NoahDobie/pajero-gauges/hardware/pcb/jlcpcb/Bottom.png

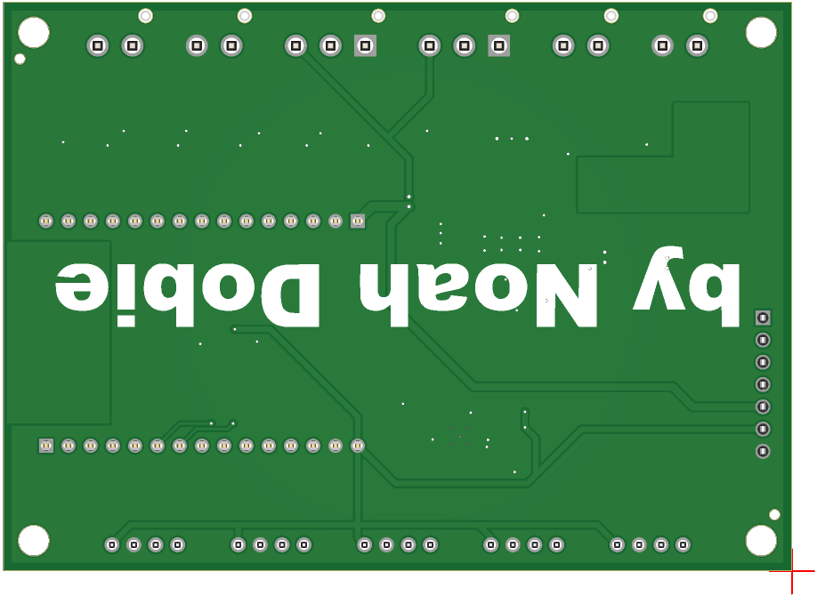
hardware/pcb/jlcpcb/Bottom.png
