NoahDobie/pajero-gauges/hardware/pcb/jlcpcb/Top.png

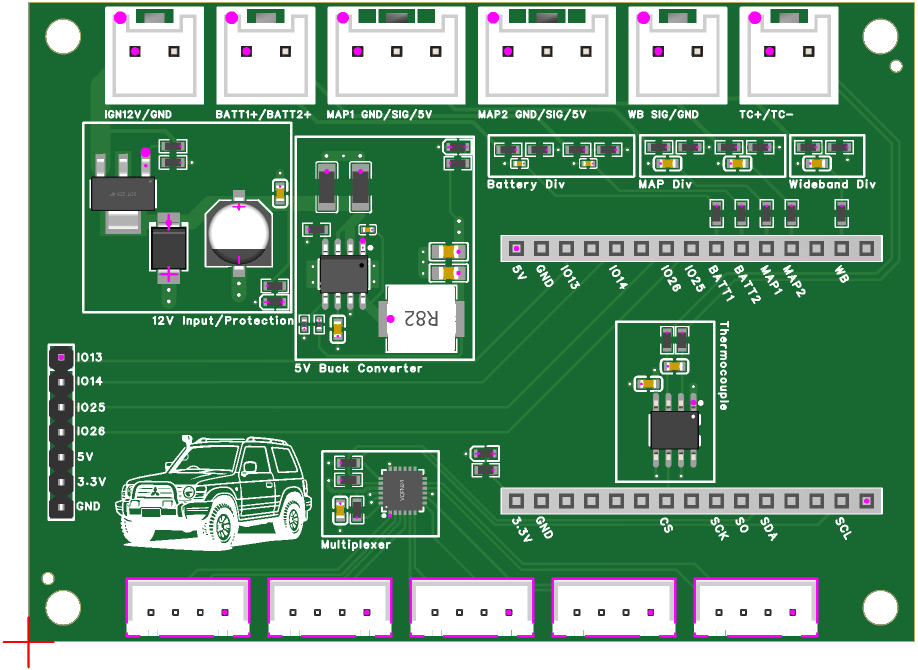
hardware/pcb/jlcpcb/Top.png
