NoahDobie/pajero-gauges/hardware/pcb/production-files/BOM.xlsx

No. | Quantity | Comment | Designator | Footprint | Value | Manufacturer Part | Manufacturer | Supplier Part | Supplier
1 | 1 | 100uF | C1 | CAP-SMD_BD6.3-L6.6-W6.6-LS7.3-FD-H7.7 | 100uF | RVT50V100M6X8 | JIERR(捷而瑞) | C47023117 | LCSC
2 | 3 | 100nF | C2,C15,C50 | C0603 | 100nF | CC0603KRX7R9BB104 | YAGEO(国巨) | C14663 | LCSC
3 | 3 | 100nF | C5,C67,C69 | C0402 | 100nF | CL05B104KB54PNC | SAMSUNG(三星) | C307331 | LCSC
4 | 2 | 22uF | C6,C7 | C0805 | 22uF | CL21A226MAQNNNE | SAMSUNG(三星) | C45783 | LCSC
5 | 2 | 10nF | C8,C14 | C0603 | 10nF | 0603B103K500NT | FH(风华) | C57112 | LCSC
6 | 3 | 47nF | C9,C12,C70 | C0603 | 47nF | CL10B473KB8NNNC | SAMSUNG(三星) | C1622 | LCSC
7 | 2 | 10uF | C51,C52 | C1206 | 10uF | CL31A106KBHNNNE | SAMSUNG(三星) | C13585 | LCSC
8 | 1 | SMBJ18A-Q | D1 | SMB_L4.3-W3.6-LS5.4-RD |  | SMBJ18A-Q | BOURNS | C1979859 | LCSC
9 | 4 | B2P-VH-FB-B(LF)(SN) | H1,H3,H6,H7 | CONN-TH_2P-P3.96_B2P-VH-FB-B-LF-SN |  | B2P-VH-FB-B(LF)(SN) | JST | C158006 | LCSC
10 | 2 | B3P-VH-FB-B(LF)(SN) | H4,H5 | CONN-TH_B3P-VH-FB-B-LF-SN |  | B3P-VH-FB-B(LF)(SN) | JST | C158000 | LCSC
11 | 5 | B4B-XH-A(LF)(SN) | H8,H9,H10,H11,H12 | CONN-TH_B4B-XH-A-LF-SN |  | B4B-XH-A(LF)(SN) | JST | C144395 | LCSC
12 | 1 | HX PZ2.54-1x7P ZZ | H13 | HDR-TH_7P-P2.54-V-M |  | HX PZ2.54-1x7P ZZ | hanxia(韩下) | C32713273 | LCSC
13 | 1 | 5.6uH | L1 | IND-SMD_L7.0-W6.6_FXL0630 | 5.6uH | FXL0630-5R6-M | cjiang(长江微电) | C475914 | LCSC
14 | 3 | KT-0603R | LED1,LED4,LED5 | LED0603-RD |  | KT-0603R | KENTO | C2286 | LCSC
15 | 1 | NTF2955T1G | Q1 | SOT-223-4_L6.5-W3.5-P2.30-LS7.0-BR |  | NTF2955T1G | onsemi(安森美) | C17265 | LCSC
16 | 5 | 10kΩ | R1,R3,R17,R18,R23 | R0603 | 10kΩ | 0603WAF1002T5E | UNI-ROYAL(厚声) | C25804 | LCSC
17 | 3 | 100kΩ | R2,R21,R22 | R0603 | 100kΩ | 0603WAF1003T5E | UNI-ROYAL(厚声) | C25803 | LCSC
18 | 6 | 1kΩ | R4,R5,R6,R7,R13,RLED3 | R0603 | 1kΩ | 0603WAF1001T5E | UNI-ROYAL(厚声) | C21190 | LCSC
19 | 3 | 20kΩ | R8,R19,R20 | R0603 | 20kΩ | 0603WAF2002T5E | UNI-ROYAL(厚声) | C4184 | LCSC
20 | 2 | 27kΩ | R9,R10 | R0603 | 27kΩ | 0603WAF2702T5E | UNI-ROYAL(厚声) | C22967 | LCSC
21 | 2 | 5.1kΩ | R11,R12 | R0603 | 5.1kΩ | 0603WAF5101T5E | UNI-ROYAL(厚声) | C23186 | LCSC
22 | 1 | 200kΩ | R14 | R0603 | 200kΩ | 0603WAF2003T5E | UNI-ROYAL(厚声) | C25811 | LCSC
23 | 1 | 115kΩ | R15 | R0402 | 115kΩ | RC0402FR-07115KL | YAGEO(国巨) | C273341 | LCSC
24 | 1 | 22.1kΩ | R16 | R0402 | 22.1kΩ | RMC040222.1K1%N | Tyohm(幸亚电阻) | C325588 | LCSC
25 | 3 | 4.7kΩ | R24,R25,RLED1 | R0603 | 4.7kΩ | 0603WAF4701T5E | UNI-ROYAL(厚声) | C23162 | LCSC
26 | 1 | 1.5kΩ | RLED2 | R0603 | 1.5kΩ | 0603WAF2701T5E | UNI-ROYAL(厚声) |  | LCSC
27 | 1 | MAX31855TASA+T | U1 | SOIC-8_L4.9-W3.9-P1.27-LS6.2-BL |  | MAX31855TASA+T | ADI(亚德诺)/MAXIM(美信) | C476183 | LCSC
28 | 1 | TCA9548ARGERQ1 | U13 | VQFN-24_L4.0-W4.0-P0.50-TL-EP2.8 |  | TCA9548ARGERQ1 | TI(德州仪器) | C2674697 | LCSC
29 | 1 | AP64352QSP-13 | U18 | ESOP-8_L4.9-W3.9-P1.27-LS6.0-BL-EP3.1-1 |  | AP64352QSP-13 | DIODES(美台) | C5248547 | LCSC
30 | 2 | HX PM2.54-1x15P ZC | U19,U20 | HDR-TH_15P-P2.54-V-F-1 |  | HX PM2.54-1x15P ZC | hanxia(韩下) | C41417327 | LCSC
