NoahDobie/pajero-gauges/hardware/schematics/SCH_Schematics.pdf

# TC_CSPGND

15 15 14 14 13 13 12 12 11 11 10 10 9

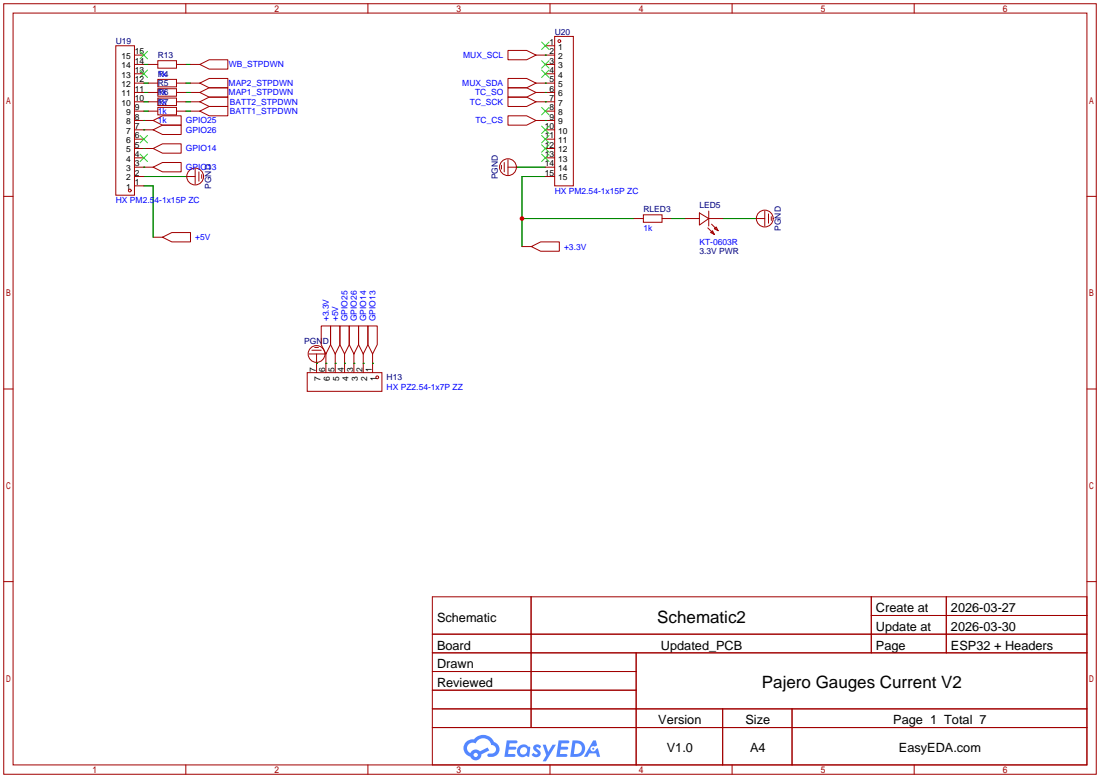
[picture p3: page 1]

Schematic | Schematic2 | Create at | 2026-03-27

Update at | 2026-03-30

Board | Updated_PCB | Page | ESP32 + Headers
Drawn | | Pajero Gauges Current V2
Reviewed

Version | Size | Page 1 Total 7
V1.0 | A4 | EasyEDA.com

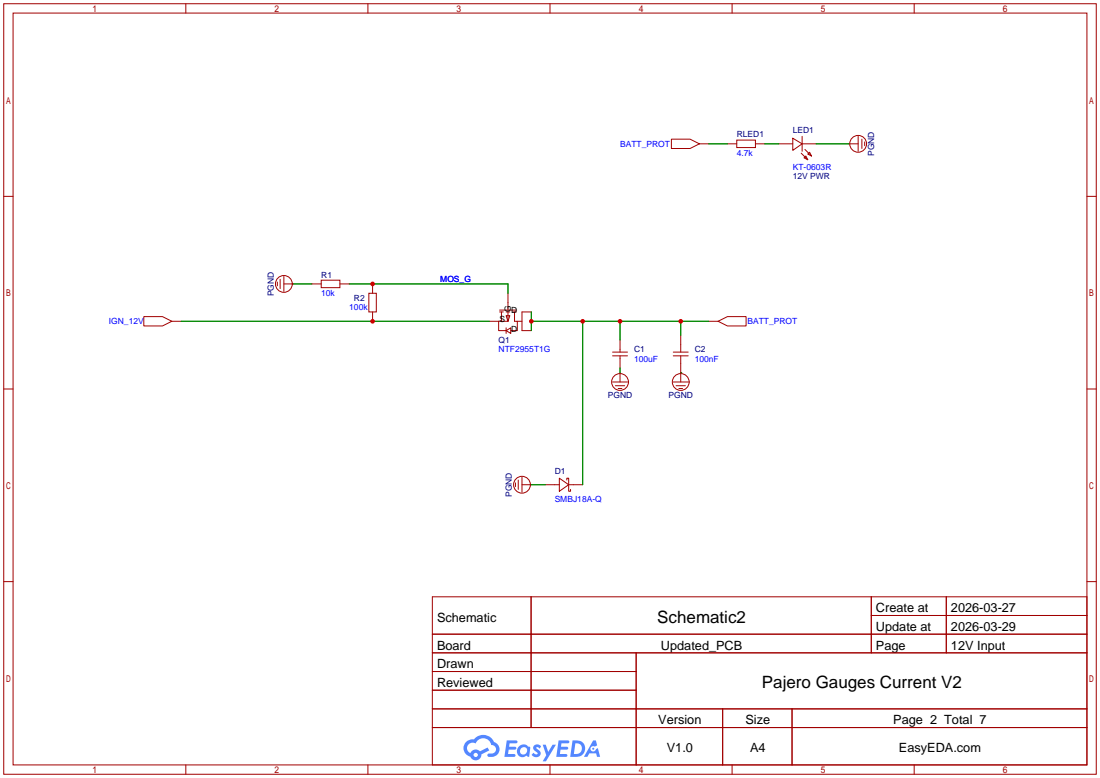
[picture p4: page 2]

Schematic | Schematic2 | Create at | 2026-03-27

Update at | 2026-03-29

Board | Updated_PCB | Page | 12V Input
Drawn | | Pajero Gauges Current V2
Reviewed

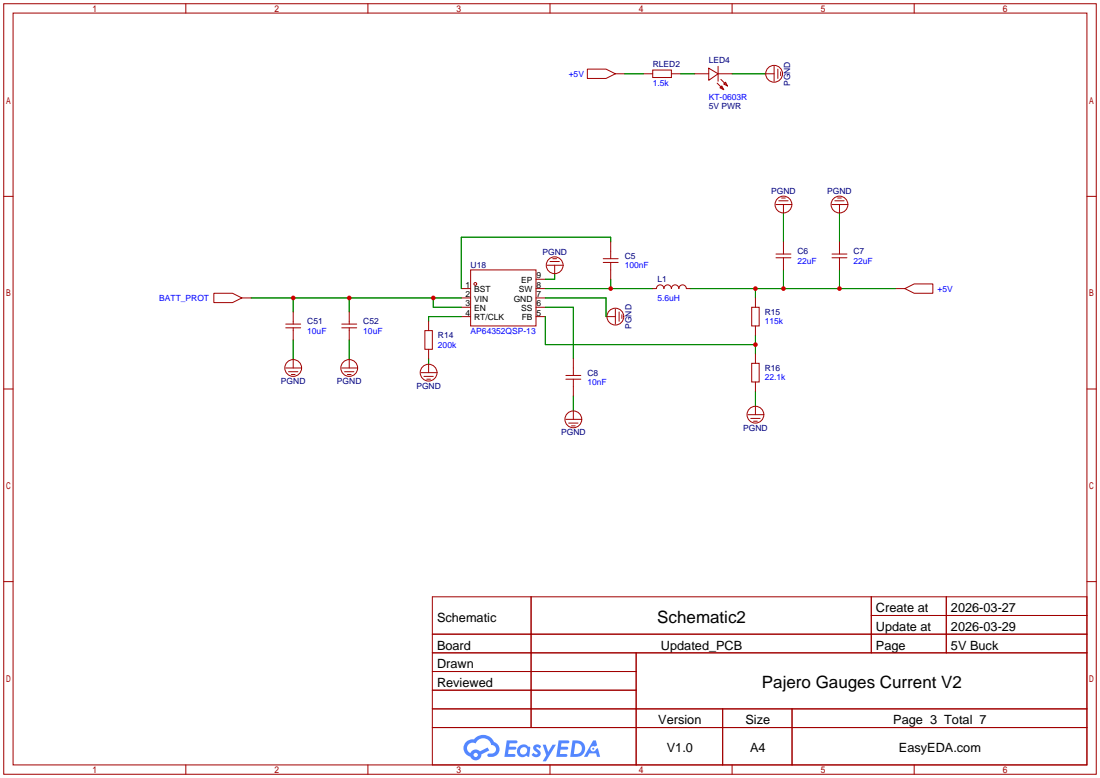
[picture p5: page 3]

Schematic | Schematic2 | Create at | 2026-03-27

Update at | 2026-03-29

Board | Updated_PCB | Page | 5V Buck
Drawn | | Pajero Gauges Current V2
Reviewed

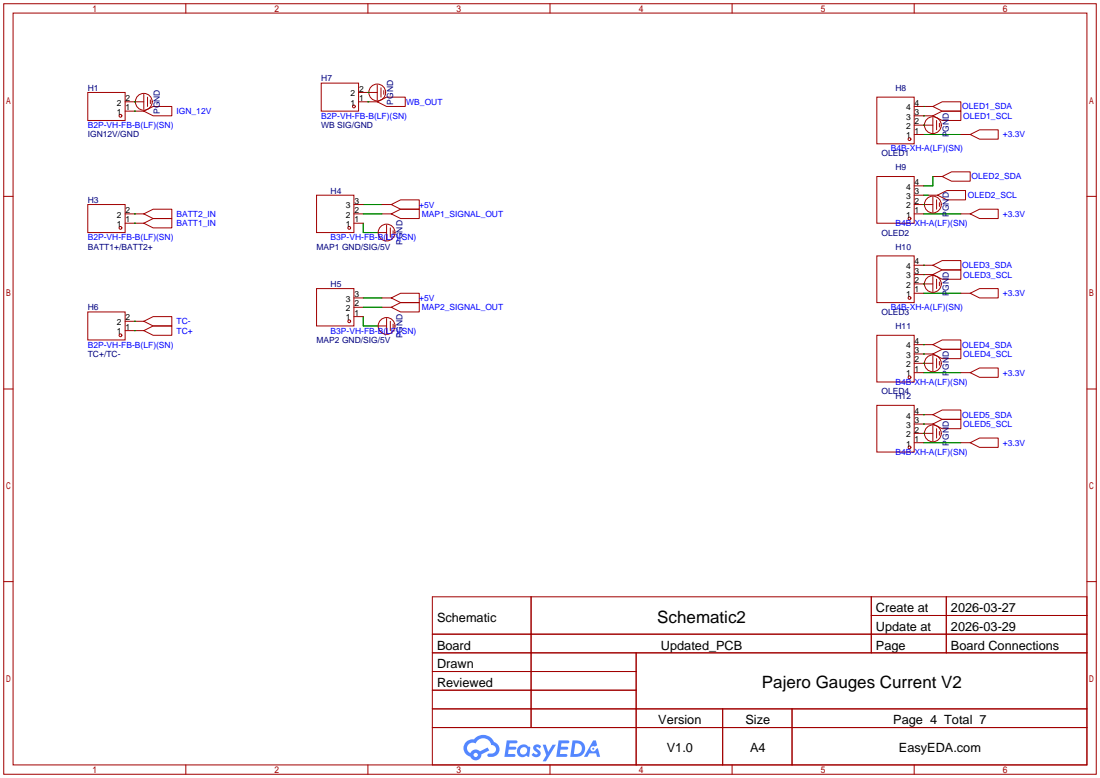
[picture p6: page 4]

Schematic | Schematic2 | Create at | 2026-03-27

Update at | 2026-03-29

Board | Updated_PCB | Page | Board Connections
Drawn | | Pajero Gauges Current V2
Reviewed

# WB_STPDWN PGND PGND

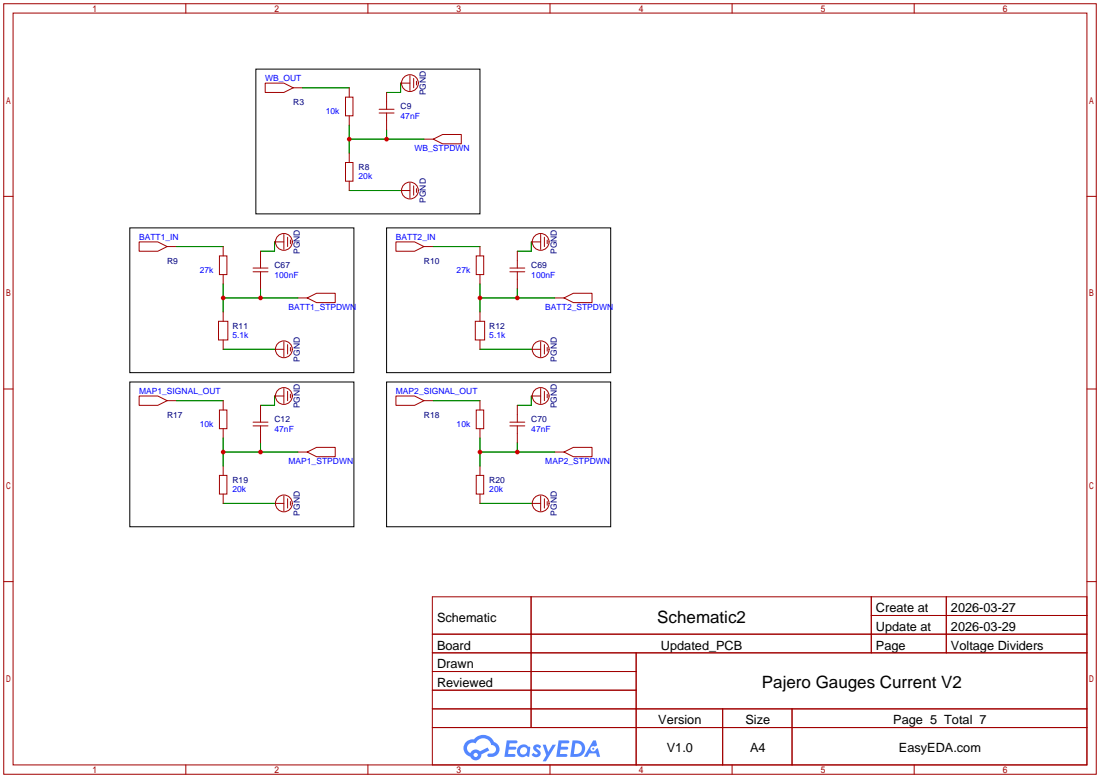
[picture p7: page 5]

Schematic | Schematic2 | Create at | 2026-03-27

Update at | 2026-03-29

Board | Updated_PCB | Page | Voltage Dividers
Drawn | | Pajero Gauges Current V2
Reviewed

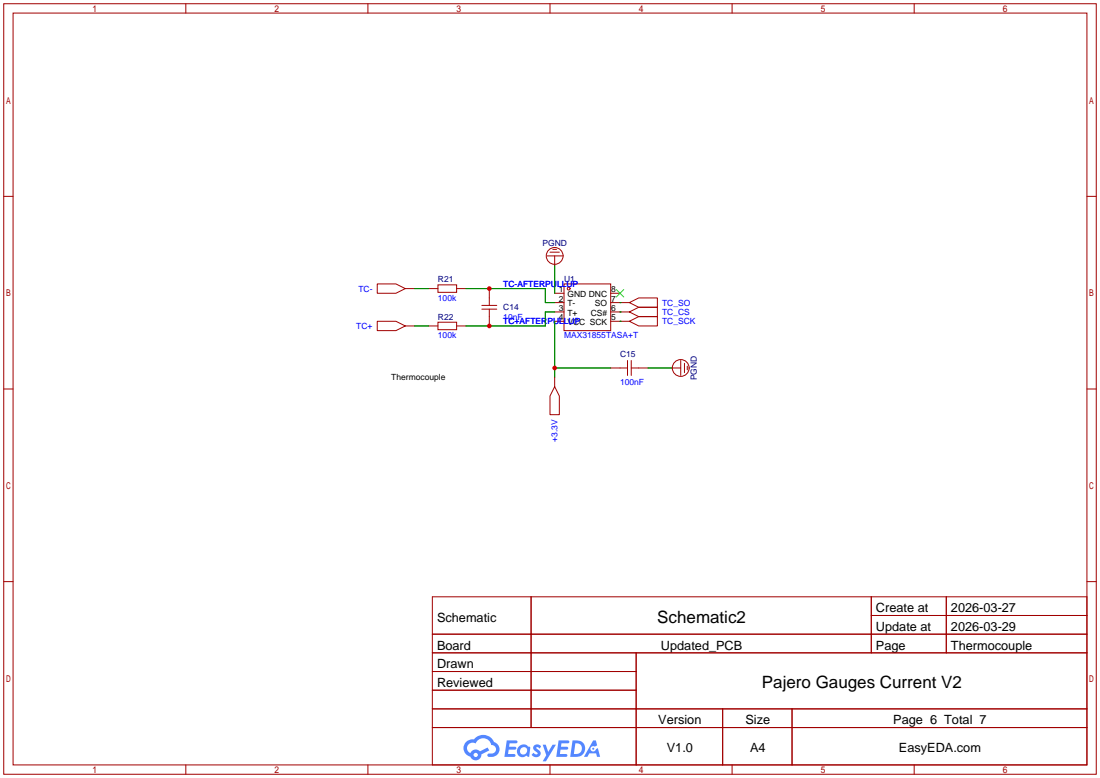
[picture p8: page 6]

Schematic | Schematic2 | Create at | 2026-03-27

Update at | 2026-03-29

Board | Updated_PCB | Page | Thermocouple
Drawn | | Pajero Gauges Current V2
Reviewed

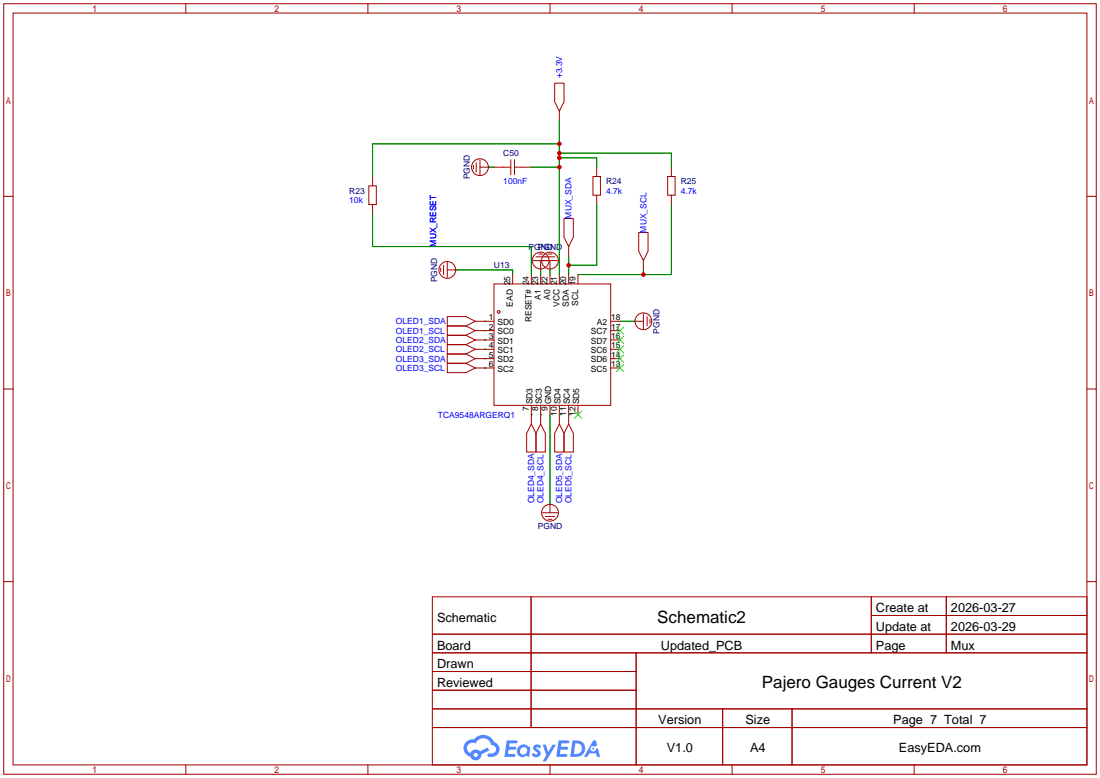
[picture p9: page 7]

Schematic | Schematic2 | Create at | 2026-03-27

Update at | 2026-03-29

Board | Updated_PCB | Page | Mux
Drawn | | Pajero Gauges Current V2
Reviewed
