NoahDobie/pajero-gauges/hardware/pcb/renders/PCB-Images.pdf

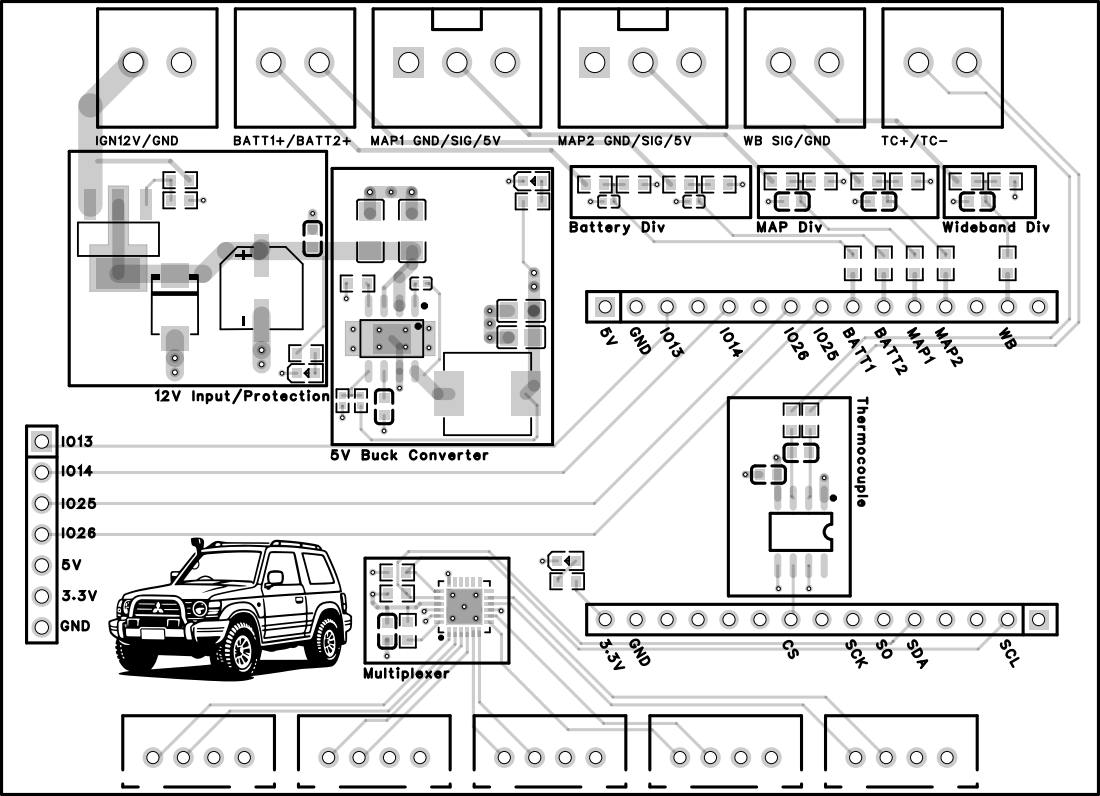
[picture p10: page 1]

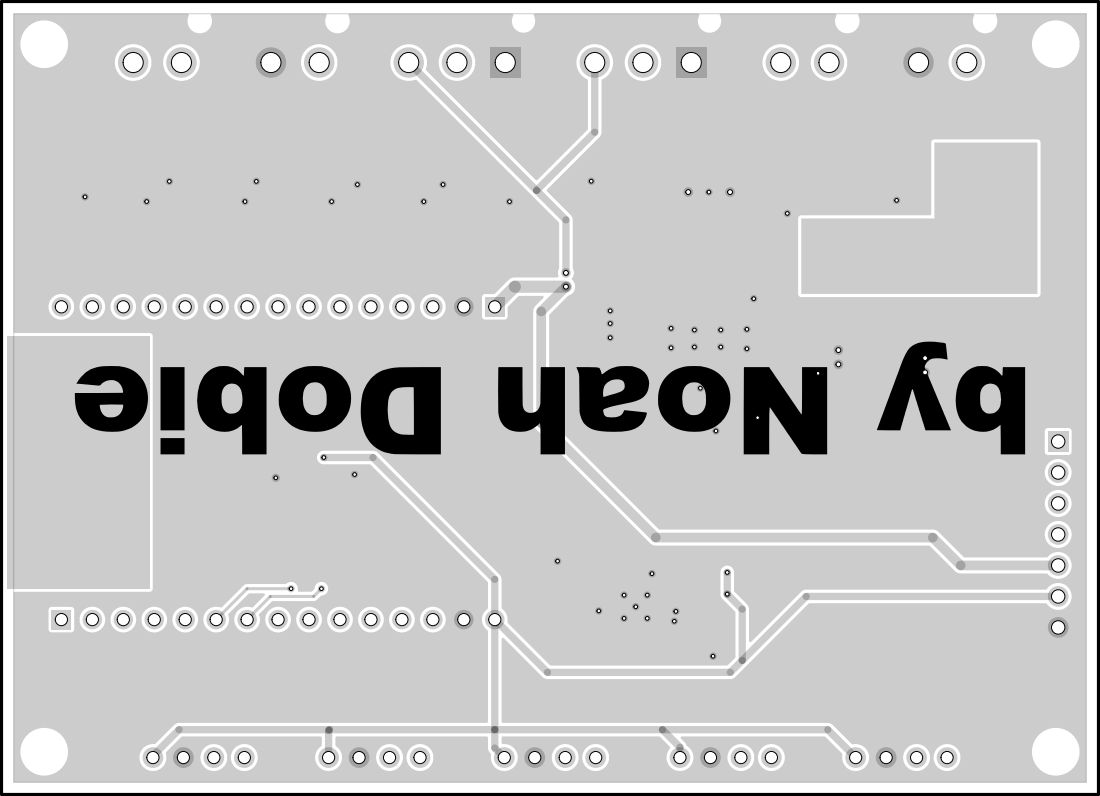
[picture p11: page 2]

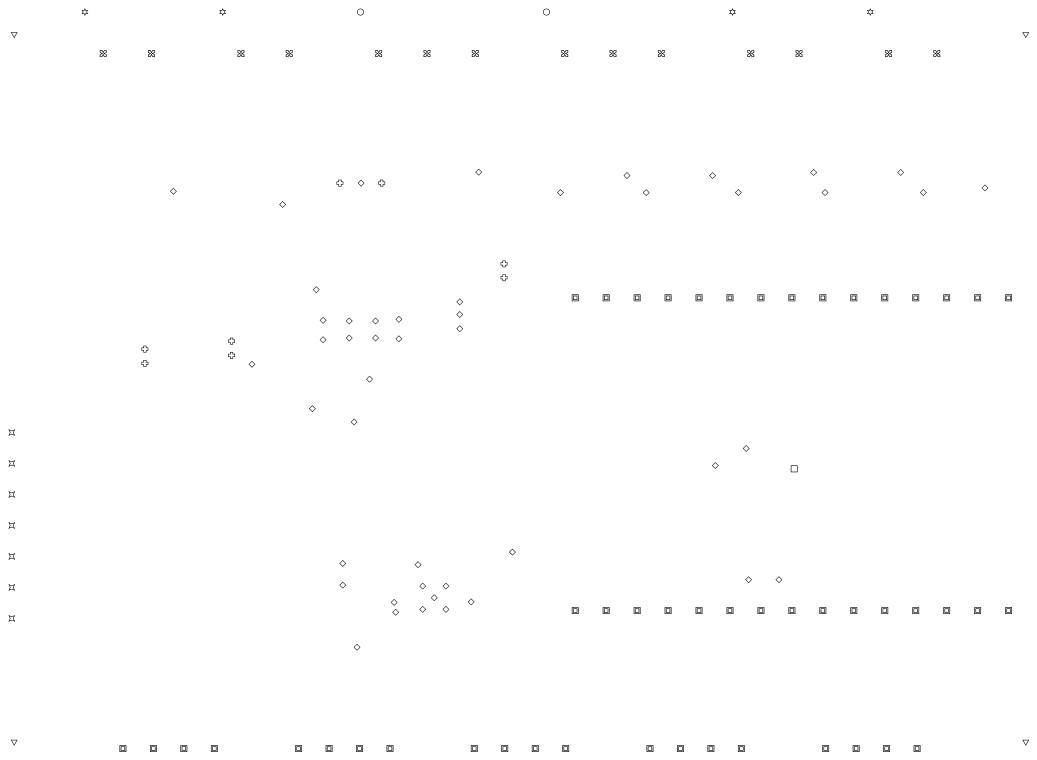
[picture p12: page 3]
