NoahDobie/pajero-gauges/(list of files, drawings)

Other design files:
hardware/easyeda-project/Pajero Gauges.epro
