NoahDobie/pajero-gauges/(commit log)

2026-04-01 Initial Hardware + Readme
    [BOM.xlsx, Pajero Gauges.epro, PickAndPlace.xlsx]
2026-04-11 Add boost and battery screens (temp screen 2 with SSD1306 instead of SH1106)
2026-04-11 Add EGT screen module and MAX31855 support for temperature monitoring
2026-04-16 Refactor display handling to use Adafruit_SH1106G for battery and EGT screens; remove SSD1306 references
2026-04-16 Add PIO test environment to prototype screens faster.
2026-04-16 Set text color explicitly and render digits immediately on battery, boost, and EGT screens to prevent blank display on initialization.
2026-04-16 Refactor rendering functions in battery, boost, and EGT screens to return change status for optimized display updates
2026-04-16 EGT and Battery screen cleanup.
2026-04-16 Add delay in setup to wait for car ignition before initializing ADC
2026-04-20 Implement EMA smoothing for battery and boost screens to reduce voltage flicker
2026-04-20 Add OTA functionality with triple-reset detection and WebSerial support
    [main.cpp, ota.cpp, ota.h]
2026-04-20 Enhance WebSerial command help with additional streaming options for battery, boost, EGT, and status
2026-04-20 Remove unused WiFi.h include and enhance WebSerial command options for battery, boost, EGT, and status streaming
2026-04-24 Add gauge_common shared utilities and update build config
    Extracts EMA smoothing, digit rendering, and bar graph logic into
    firmware/src/common/ to eliminate duplication across screen modules.
    Adds BUILD_VERSION flag and includes common/ in the test build filter.
2026-04-24 Refactor screen modules to use gauge_common shared utilities
    Replaces duplicated EMA smoothing, digit rendering, and bar graph logic
    in afr, battery, boost, and egt screens with calls to gauge_common.
2026-04-24 Refactor main loop to non-blocking timing and fix MAP2 sampling
    Replaces delay(UPDATE_INTERVAL_MS) with a timestamp check so the loop
    is fully non-blocking. Moves MAP2 barometric reference sampling outside
    the boost-only block so it always runs regardless of ENABLE_BOOST.
    Adds EGT frame counter to rate-limit thermocouple reads.
    [main.cpp]
2026-04-24 Enhance production OTA WebSerial commands and diagnostics
    Adds mem, wifi, perf, and errors WebSerial commands. Improves OTA
    progress callbacks to report named errors and 10% increments.
    Adds logBoth(), formatUptime() helpers, loop timing tracking, and
    ota_logError() for storing the last error for retrieval via WebSerial.
    [ota.cpp, ota.h]
2026-04-24 Enhance test harness OTA commands and fix AFR simulation range
    Mirrors production OTA improvements: named error callbacks, logBoth(),
    formatUptime(), loop timing tracking, and mem/wifi/perf commands.
    Adds ota_setCurrentScreen() so the screen command reports current state.
    Fixes AFR simulation range from 10-20 to the correct 15-50.
    [main.cpp, ota.cpp, ota.h]
